WiseL00k/My_TD4CPU/原理图/ROM板.pdf

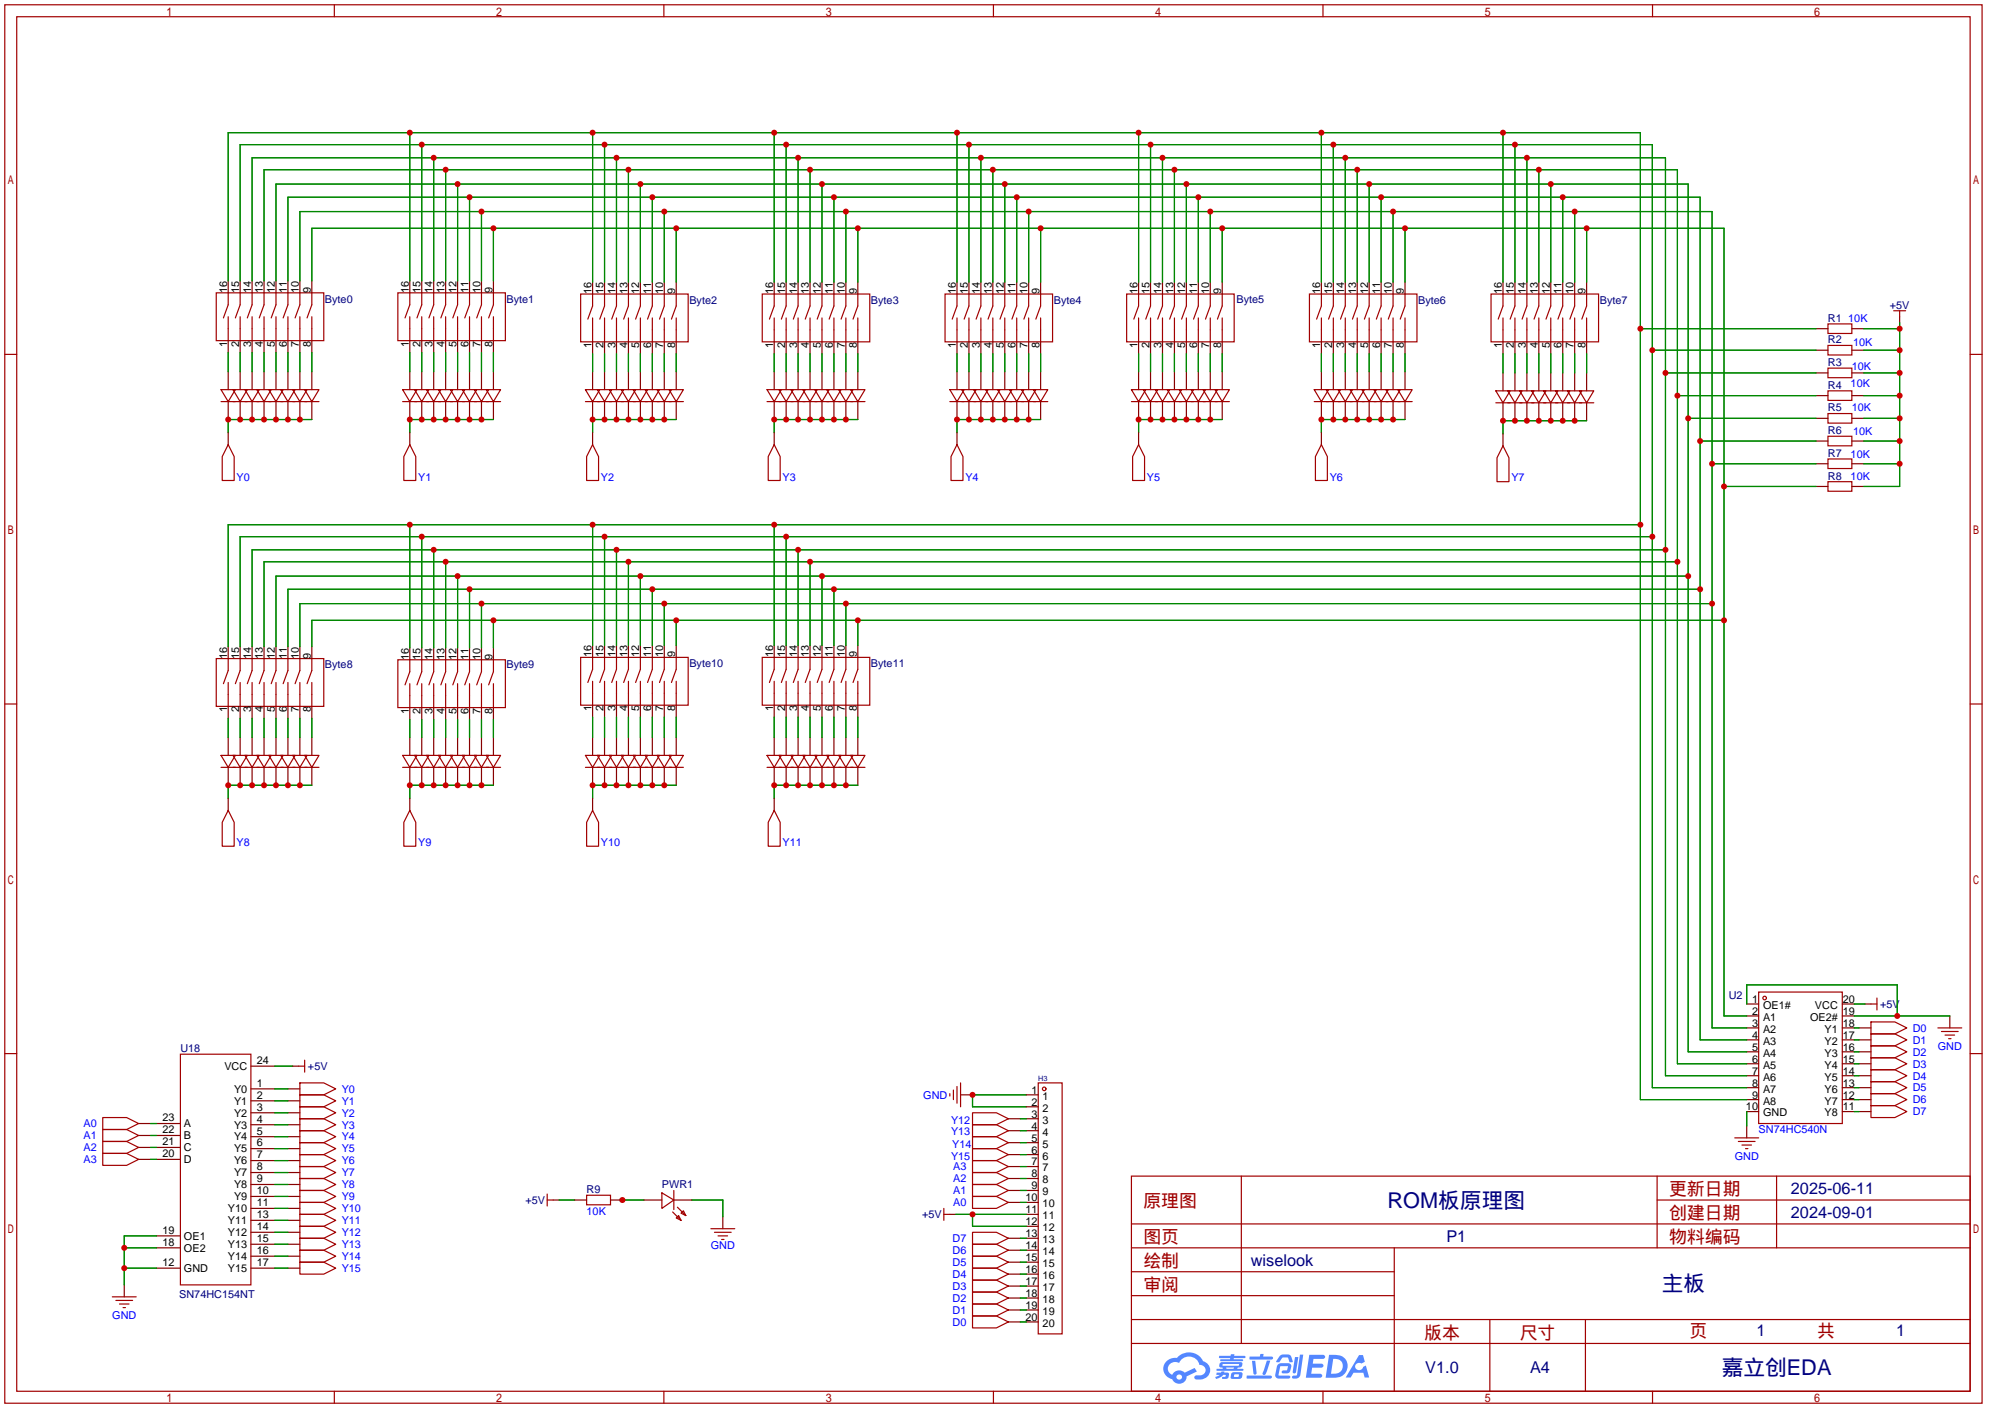
[picture p4: page 1]
