WiseL00k/My_TD4CPU/原理图/主板.pdf

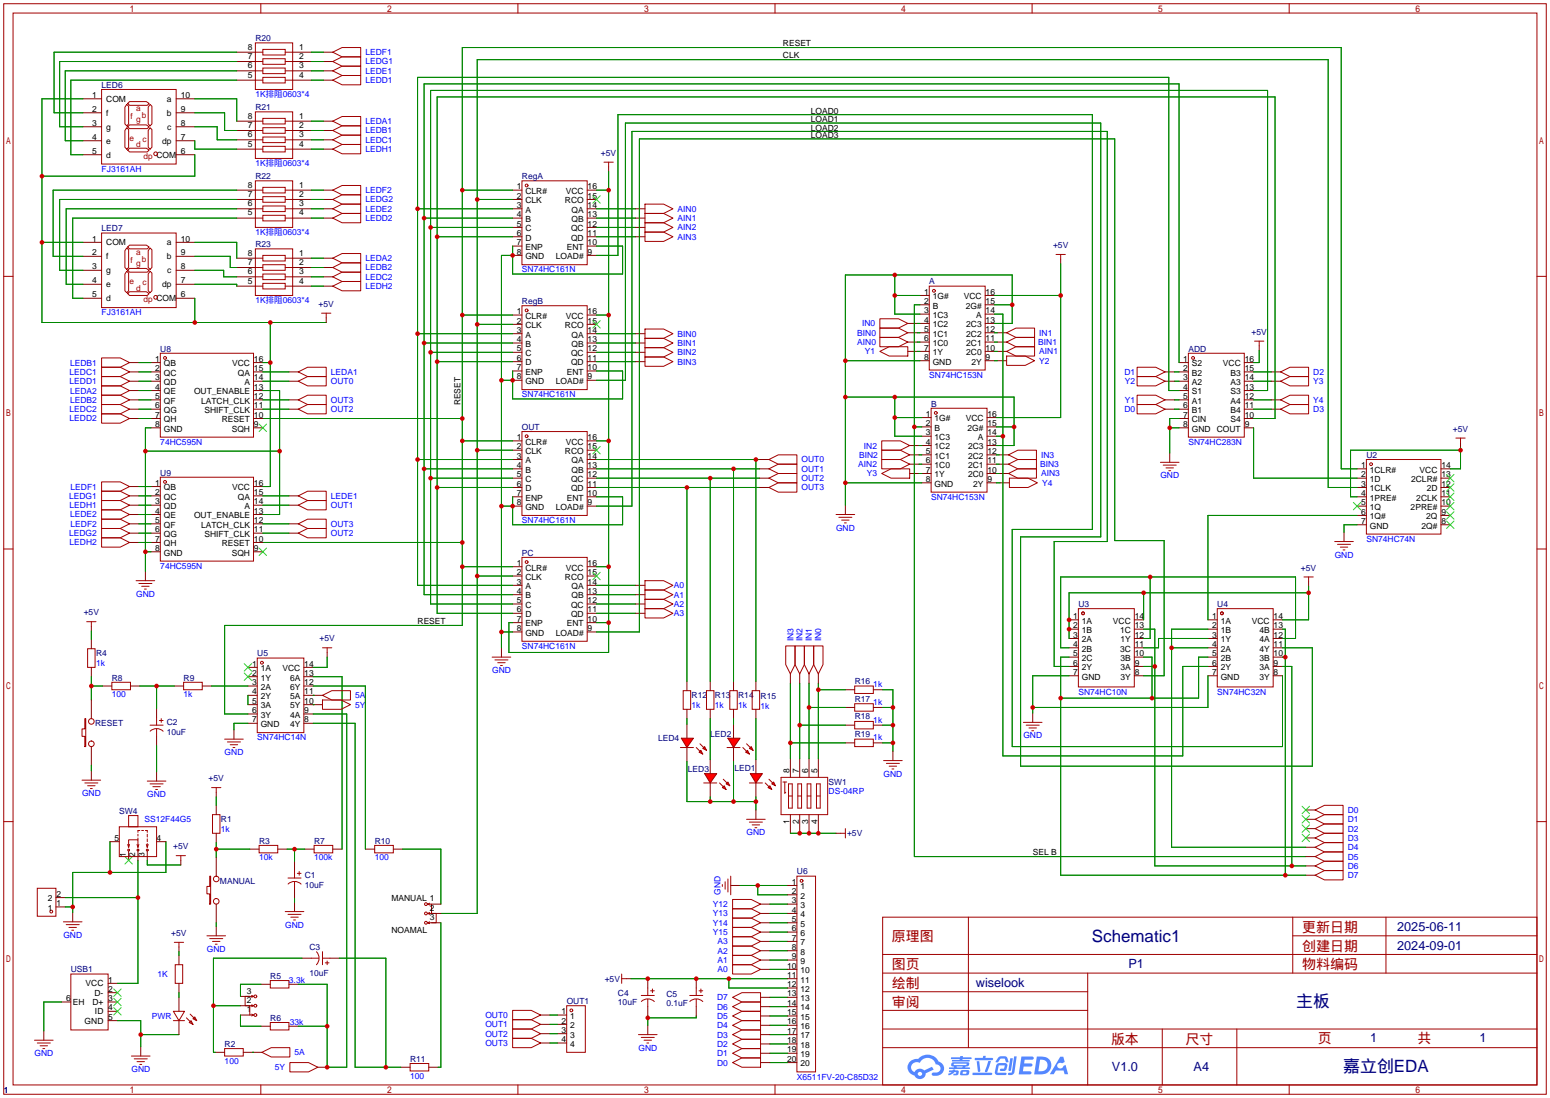
[picture p5: page 1]
