WiseL00k/My_TD4CPU/(list of files, drawings)

Other design files:
ROM外接板/ROM外接板.eprj
主板/主板.eprj
