WiseL00k/My_TD4CPU/(commit log)

2025-06-11 Init repo.
    [ROM外接板.eprj, 主板.eprj]
2025-06-11 Add Schematic diagram.
